mikeoverbay/drum-amp-jukebox/cad/decals/arduino_uno_r3_top_decal.png

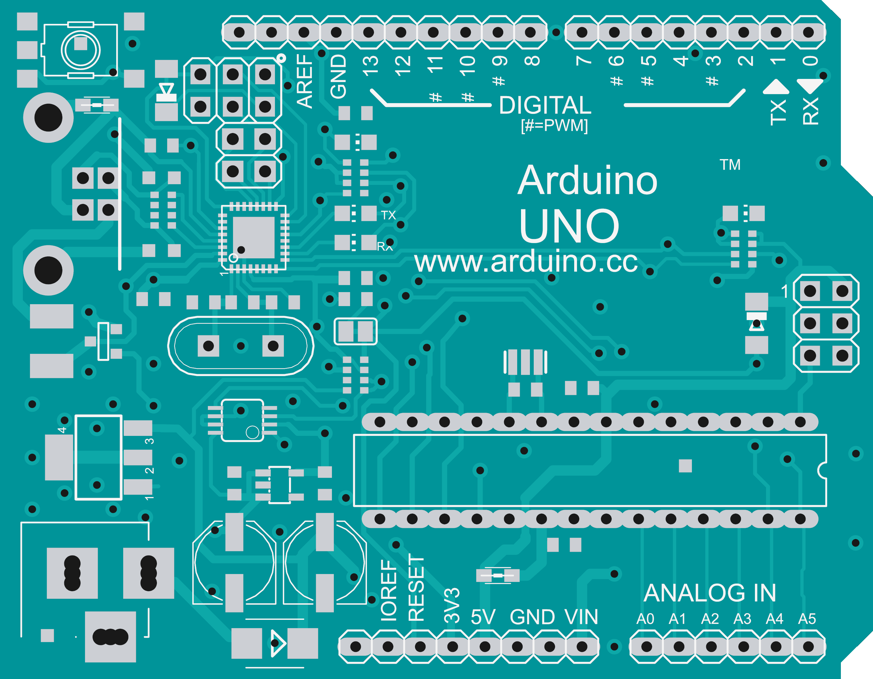
cad/decals/arduino_uno_r3_top_decal.png
