mikeoverbay/drum-amp-jukebox/cad/previews/console_exploded.png

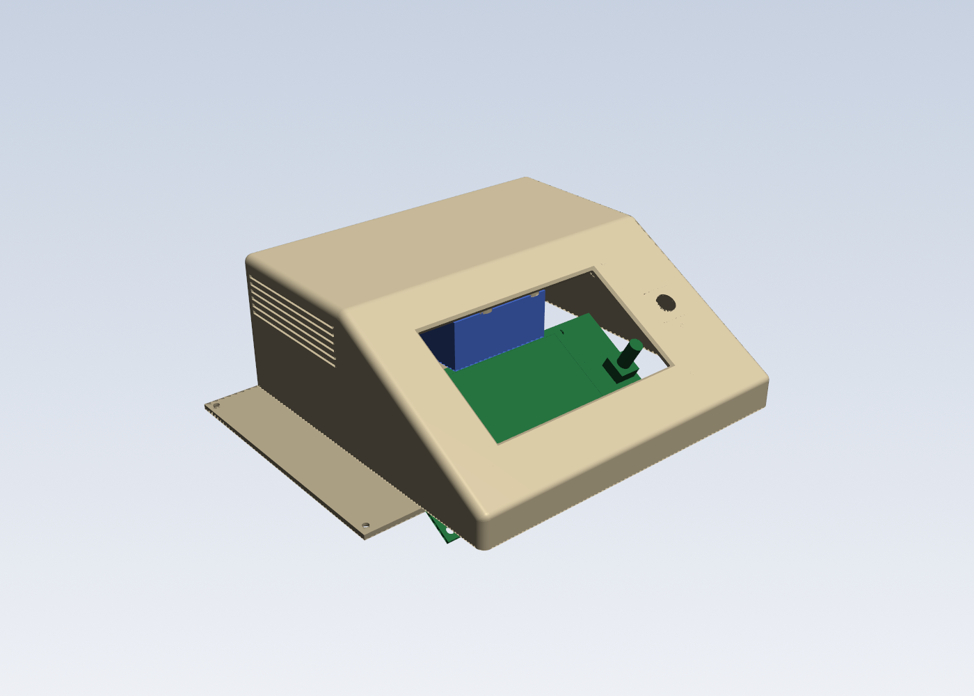
cad/previews/console_exploded.png
