mikeoverbay/drum-amp-jukebox/cad/previews/console_sections.png

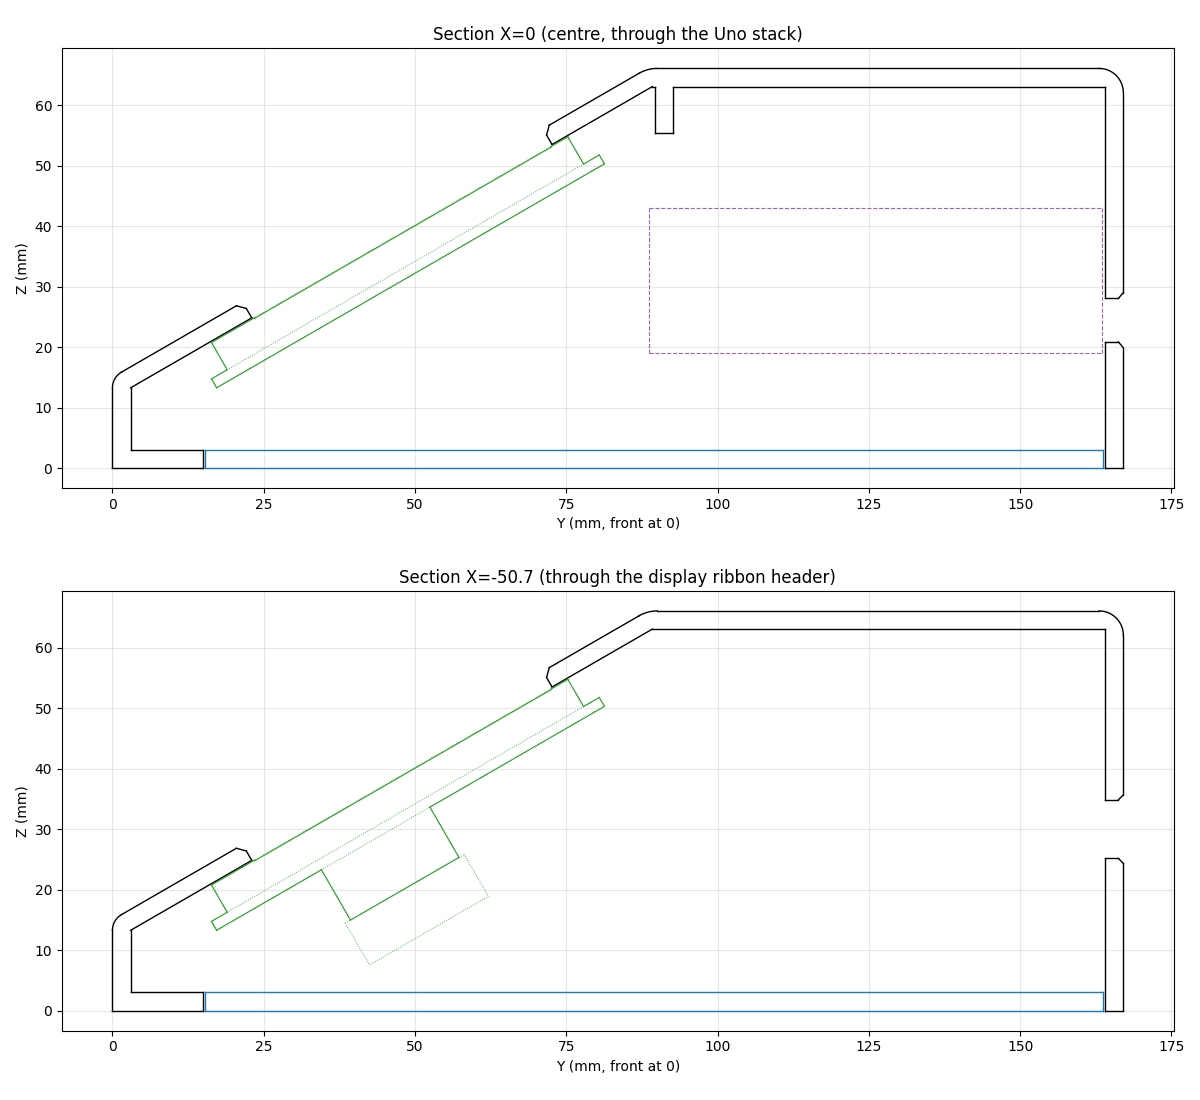
cad/previews/console_sections.png
