mikeoverbay/drum-amp-jukebox/cad/previews/uno_art_top.png

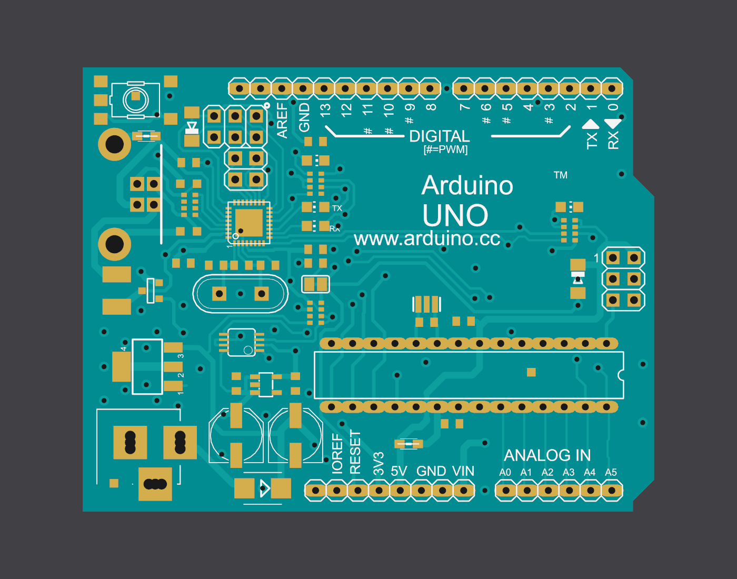
cad/previews/uno_art_top.png
