mikeoverbay/drum-amp-jukebox/cad/previews/uno_coloured.png

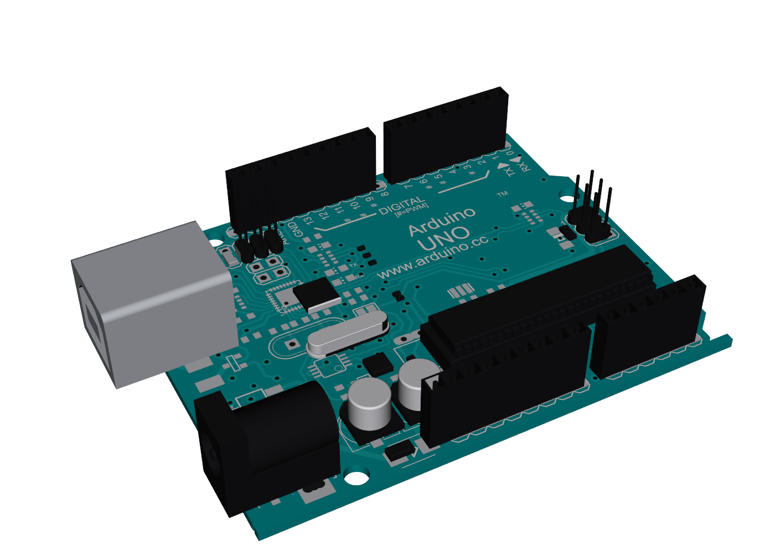
cad/previews/uno_coloured.png
