mikeoverbay/drum-amp-jukebox/cad/previews/vent_closeup.png

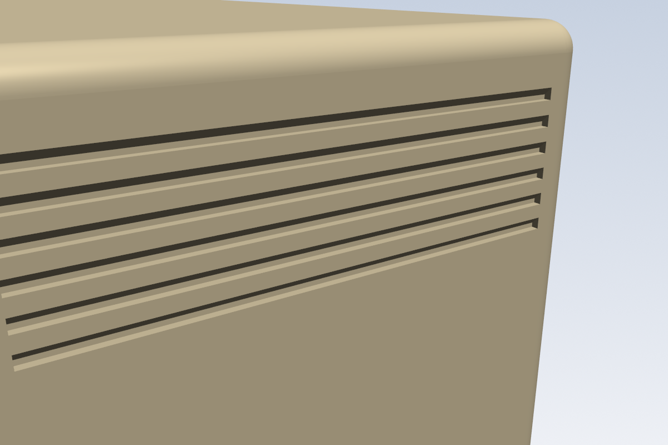
cad/previews/vent_closeup.png
