mikeoverbay/drum-amp-jukebox/cad/previews/vent_section.png

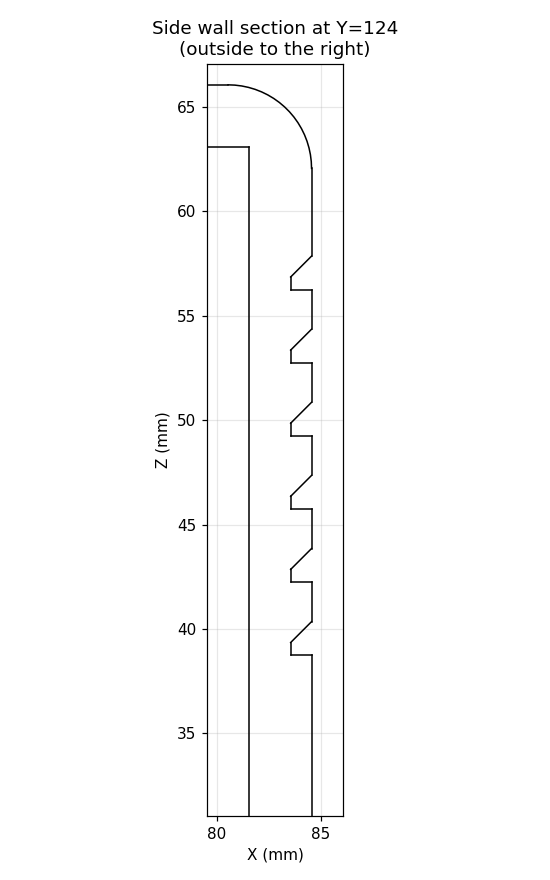
cad/previews/vent_section.png
