mikeoverbay/drum-amp-jukebox/firmware/drum_player/DWIN_SET/0_start.jpg

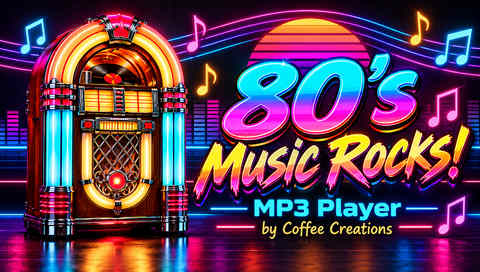
firmware/drum_player/DWIN_SET/0_start.jpg
