mikeoverbay/drum-amp-jukebox/cad/drum_case_assembly.step

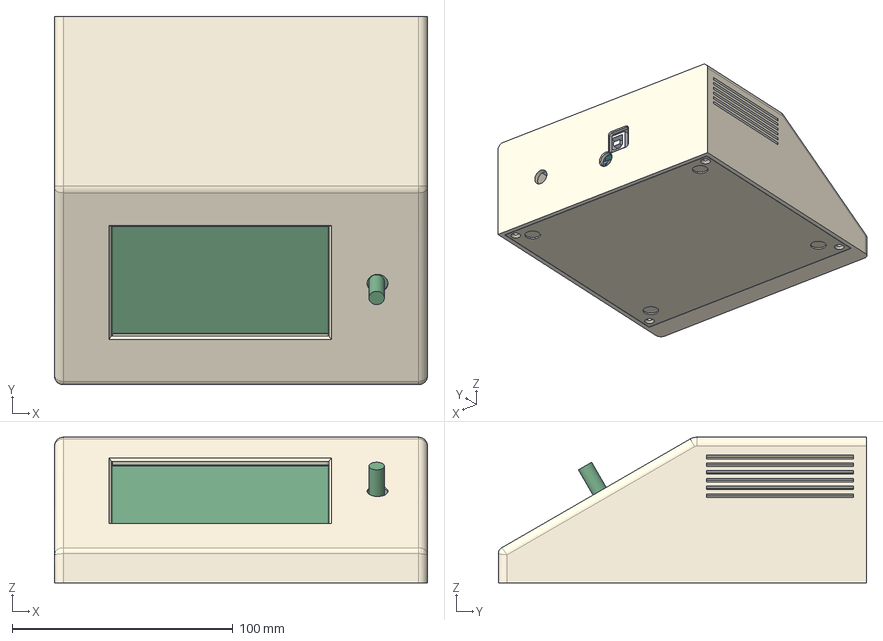
[picture p12: CAD file, 2026-10-24]
cad/drum_case_assembly.step
169.1 x 167.1 x 66.0 mm
hood
bottom_cover
display_DisplayV2
uno
pcb
jack_3_5mm
speaker_terminal_L
speaker_terminal_R
vs1053
microsd
74hc4050
ts2012_amp
regulator
crystal
reset_button
cap_c1
cap_c2
header_plastic_0
header_plastic_1
header_plastic_2
header_plastic_3
header_pins
