mikeoverbay/drum-amp-jukebox/cad/reference/adafruit_music_maker_amp.step

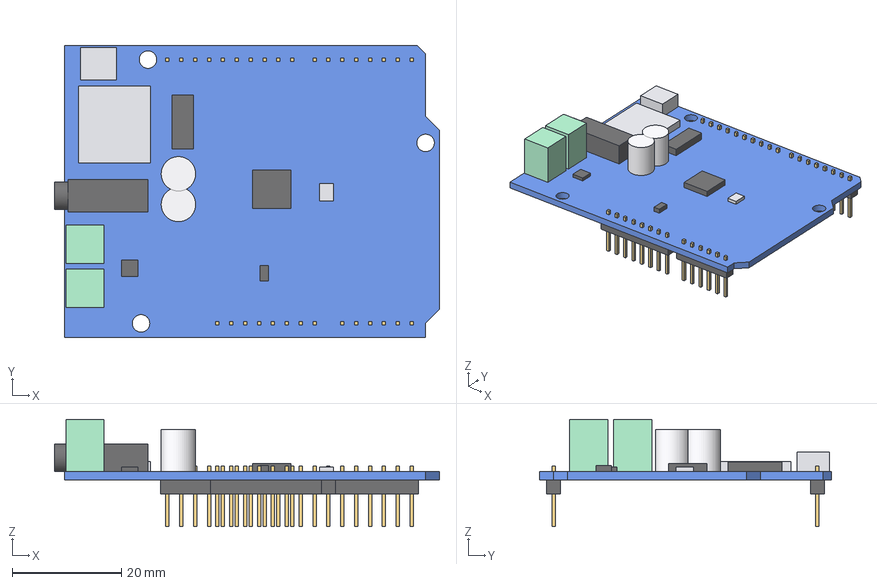
[picture p13: CAD file, 2026-10-23]
cad/reference/adafruit_music_maker_amp.step
70.4 x 53.3 x 19.6 mm
pcb
jack_3_5mm
speaker_terminal_L
speaker_terminal_R
vs1053
microsd
74hc4050
ts2012_amp
regulator
crystal
reset_button
cap_c1
cap_c2
header_plastic_0
header_plastic_1
header_plastic_2
header_plastic_3
header_pins
