mikeoverbay/drum-amp-jukebox/cad/drum_case_hood.step

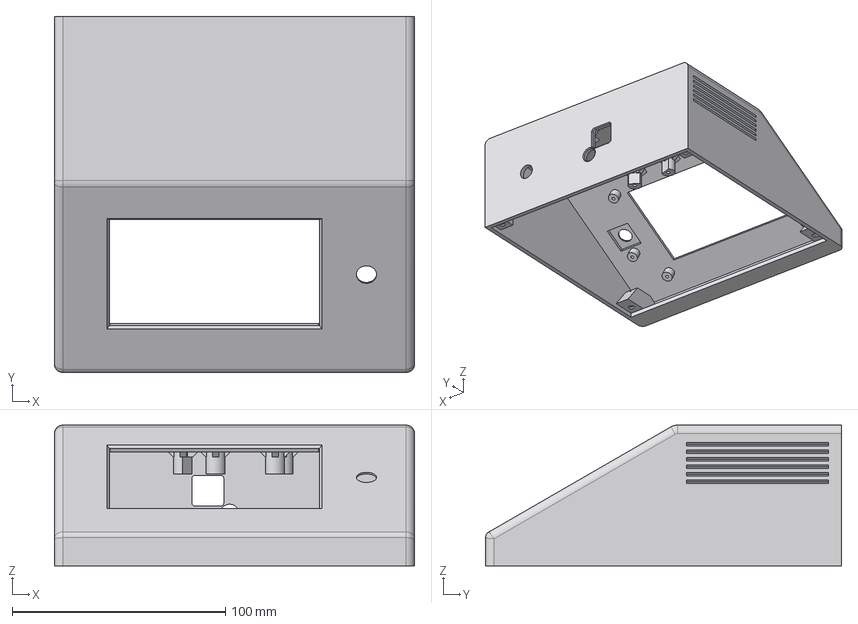
[picture p14: CAD file, 2026-10-24]
cad/drum_case_hood.step
169.1 x 167.1 x 66.0 mm
