mikeoverbay/drum-amp-jukebox/cad/reference/arduino_uno_r3_coloured.step

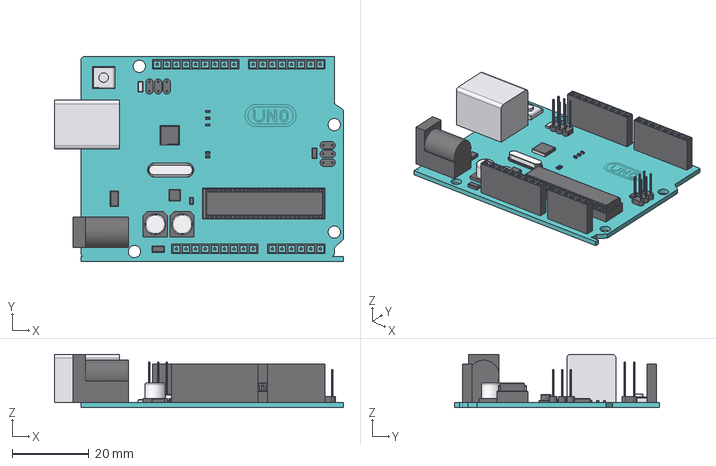
[picture p15: CAD file, 2026-10-23]
cad/reference/arduino_uno_r3_coloured.step
75.3 x 53.3 x 13.9 mm
