mikeoverbay/drum-amp-jukebox/cad/drum_case_bottom_cover.step

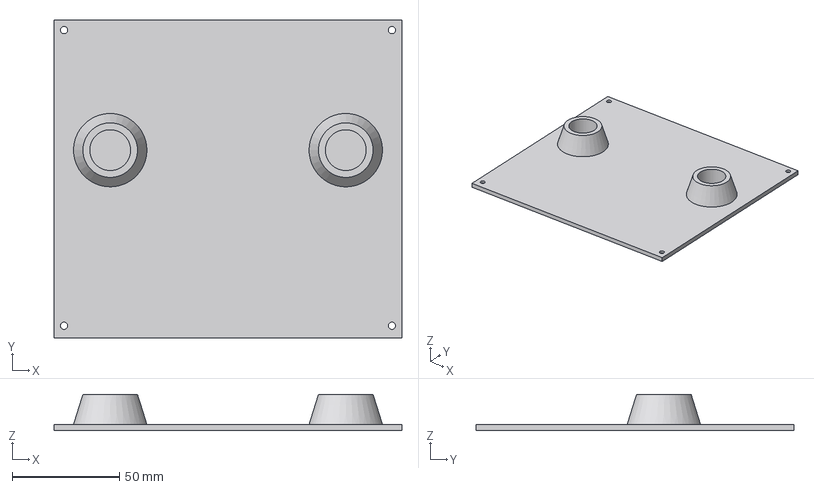
[picture p16: CAD file, 2026-10-24]
cad/drum_case_bottom_cover.step
162.5 x 148.5 x 17.0 mm
