mikeoverbay/drum-amp-jukebox/cad/reference/arduino_uno_r3.step

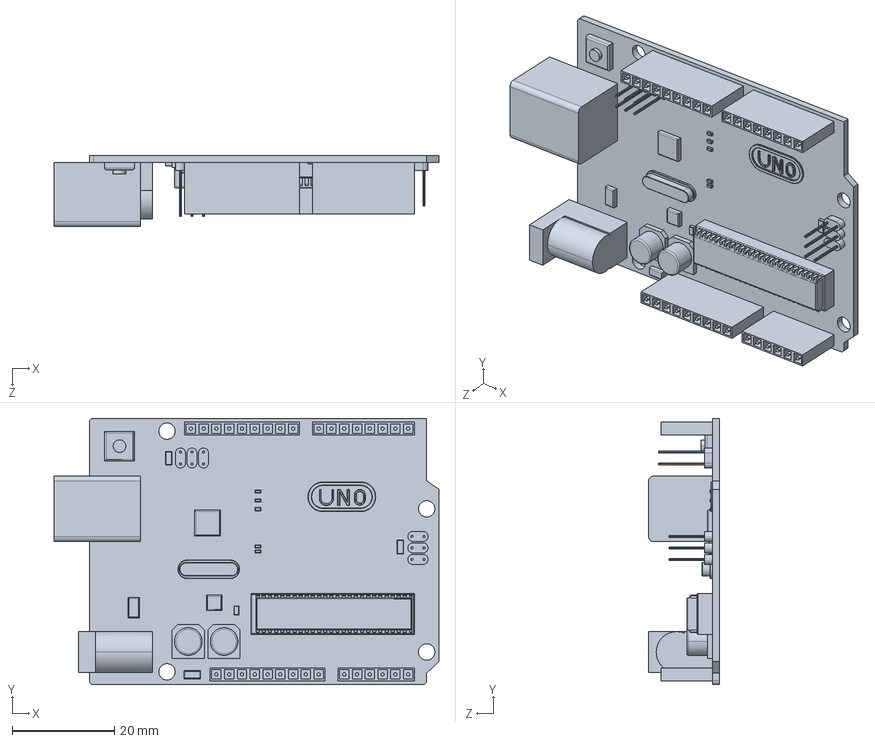
[picture p17: CAD file, 2026-10-21]
cad/reference/arduino_uno_r3.step
75.3 x 52.1 x 13.9 mm
