mikeoverbay/drum-amp-jukebox/cad/reference/DisplayV2.step

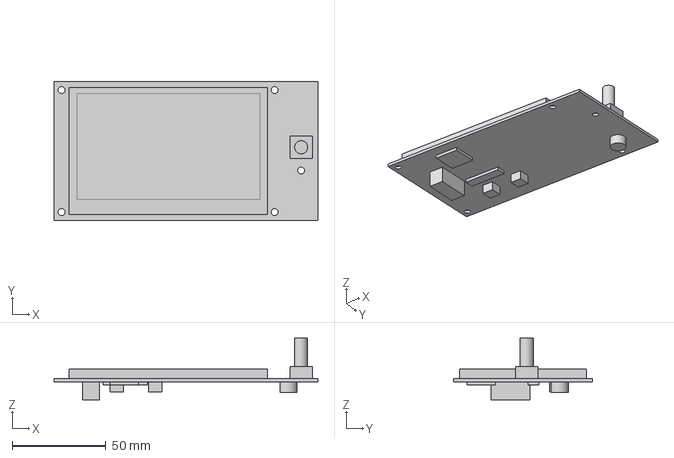
[picture p18: CAD file, 2026-10-21]
cad/reference/DisplayV2.step
141.0 x 74.0 x 32.9 mm
