mikeoverbay/drum-amp-jukebox/(list of files, cad)

Other CAD files:
cad/stl/drum_case_bottom_cover.stl
cad/stl/drum_case_hood.stl
