mikeoverbay/drum-amp-jukebox/cad/decals/music_maker_rev_e_top_decal.png

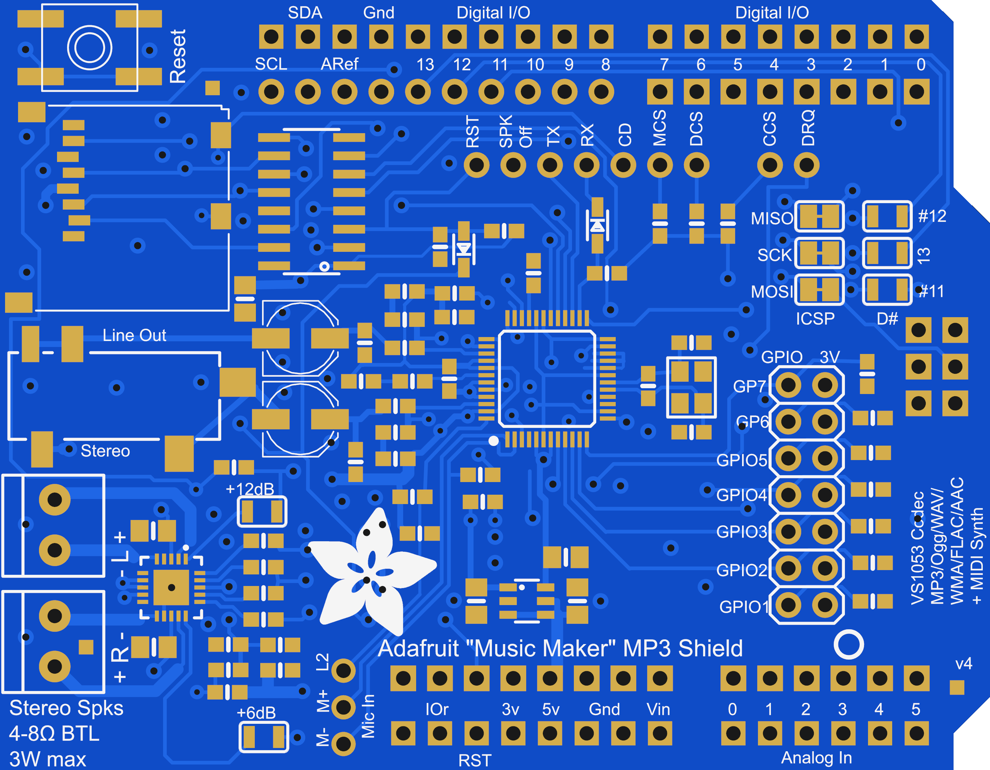
cad/decals/music_maker_rev_e_top_decal.png
