mikeoverbay/drum-amp-jukebox/cad/previews/assembly_back_opening.png

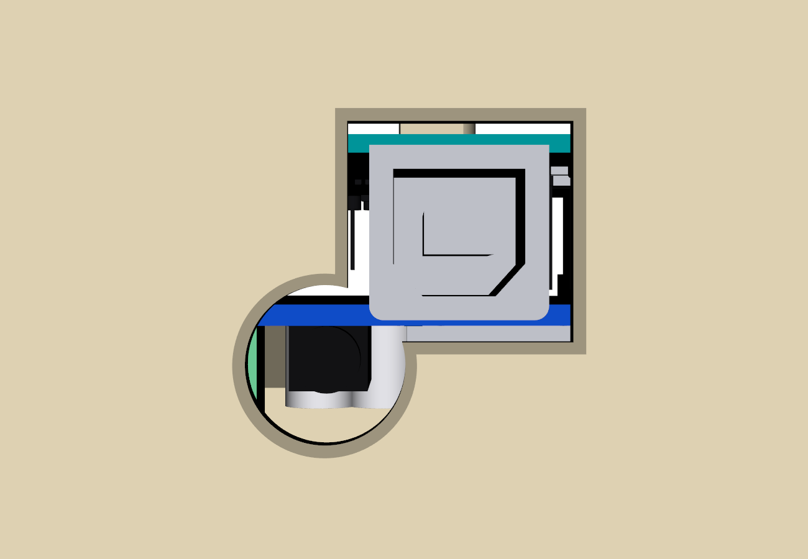
cad/previews/assembly_back_opening.png
