mikeoverbay/drum-amp-jukebox/cad/previews/assembly_inside.png

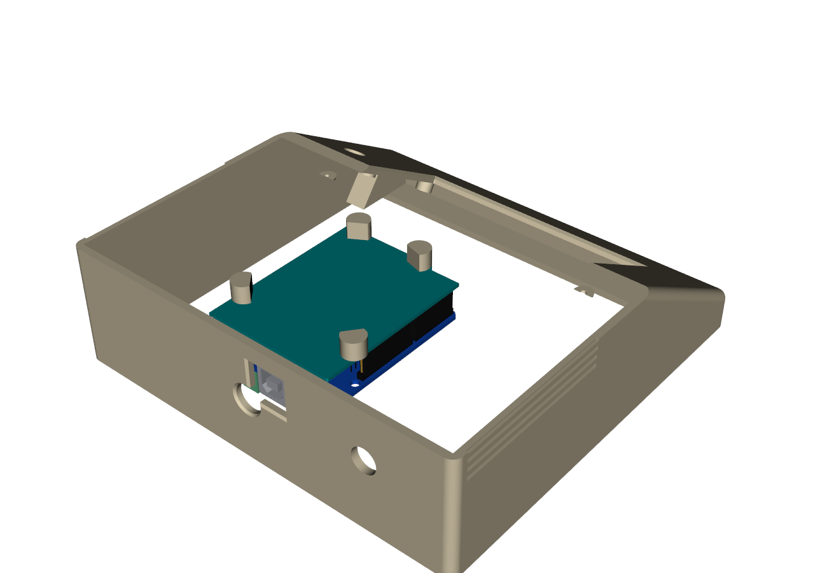
cad/previews/assembly_inside.png
