mikeoverbay/drum-amp-jukebox/cad/previews/music_maker_amp.png

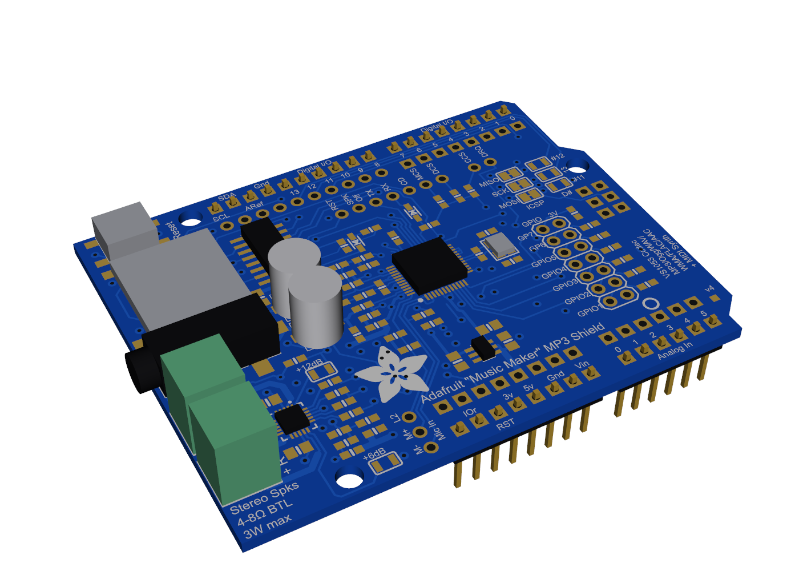
cad/previews/music_maker_amp.png
