mikeoverbay/drum-amp-jukebox/cad/previews/music_maker_art_top.png

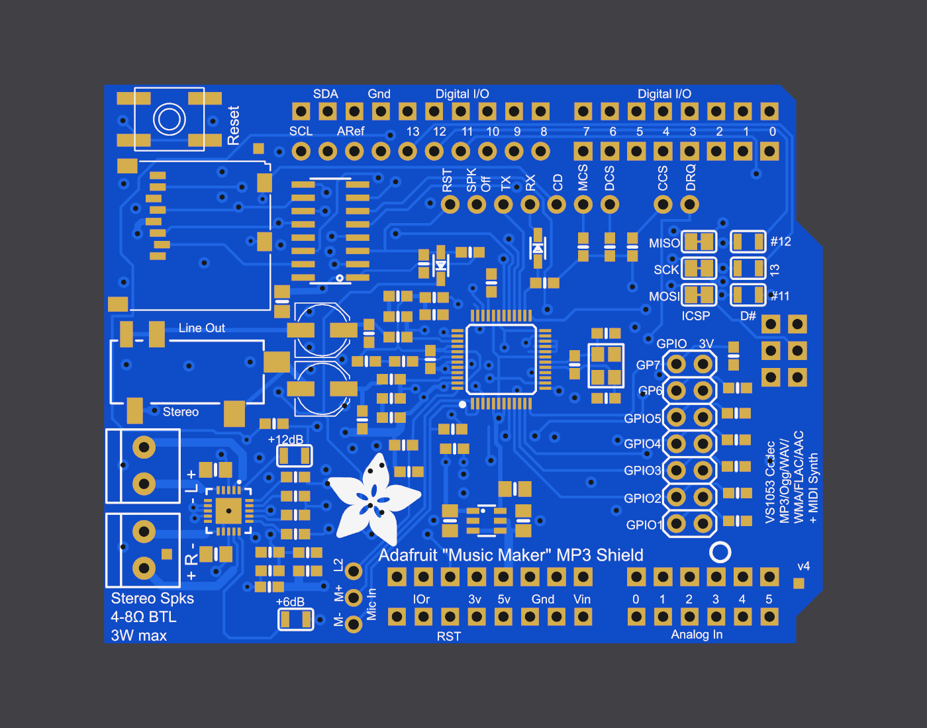
cad/previews/music_maker_art_top.png
