mikeoverbay/drum-amp-jukebox/cad/previews/uno_music_maker_stack.png

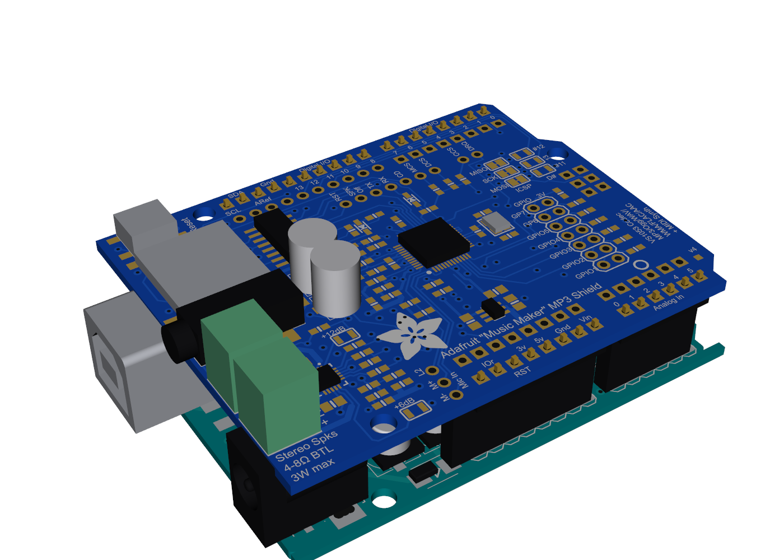
cad/previews/uno_music_maker_stack.png
