mikeoverbay/drum-amp-jukebox/(commit log)

2026-10-21 First commit: drum-amp-jukebox
    Uno + HW-261 VS1053 MP3 jukebox feeding a Donner DDA-80 drum amp, with
    an Ender-3 V2 DWIN screen and knob.
    - firmware/hw261_mp3_player: the sketch, the screen flash set, button art
    - cad: T-shaped printed case (CadQuery source, STEP files, shield and
    reference models)
    - sd-card: song index tool, title list, VS1053 patches
    - docs: parts list and wiring
    [DisplayV2.step, T5UIC1.CFG, arduino_uno_r3.step, drum_case_assembly.step, drum_case_hood.step, drum_case_tray.step, uno_vs1053_stack.step, vs1053_hw261_shield.step]
2026-10-21 Wiring notes from the firmware session
    Knob common to GND, keep D2 and D6-D9 free, which jack is the audio
    out, and the Tone popup.
2026-10-21 Case: back wall on the hood, bottom cover, bevelled screw blocks
    - Back wall moved from the tray to the hood so the hood prints standing
    on its flat back; the tray is now just a floor plate, renamed the
    bottom cover (drum_case_bottom_cover.step).
    - Back pillars replaced by floor-level corner blocks, screws 8 mm in
    from the outside of the walls.
    - Back wall 10 mm further back (REAR_CLEAR 22): 169.1 x 173.9 x 66.
    - Side-wall screw blocks are 45 degree wedges that print without
    support; every pilot has a 0.8 mm lead-in chamfer.
    [drum_case_assembly.step, drum_case_bottom_cover.step, drum_case_hood.step, drum_case_tray.step]
2026-10-21 Rename firmware to drum_player; clean out old case code
    - firmware/hw261_mp3_player -> firmware/drum_player (drum_player.ino),
    matching the renamed Documents\Arduino\drum_player sketch; old folder
    names updated in the docs and MakeSongIndex.ps1.
    - drum_case.py: tray -> bottom cover throughout (make_bottom_cover),
    pillars -> back screws; removed the unused deck text, lid seam, vents,
    power-jack hole option and back-on-tray/lip option. The exported
    hood and bottom cover are unchanged (same volumes).
    - README: dropped notes about the removed options.
    [T5UIC1.CFG, drum_case_assembly.step, drum_case_bottom_cover.step, drum_case_hood.step]
2026-10-21 Add shaded PNG views of the case and the script that renders them
    cad/render_views.py tessellates the exported hood and bottom cover and
    draws front, back, underneath and assembly views with matplotlib.
2026-10-22 Switch to the Music Maker and the console case
    - firmware/drum_player: now runs on the Adafruit Music Maker
    (player(-1, 7, 6, 3, 4), SD CS 4); the red HW-261 shield is dropped.
    docs/wiring.md and README updated to match (from the firmware session).
    - cad/: the T-shaped drum case and the HW-261 shield model are replaced
    by the sloped console case (the coffee player's design):
    - stl/hood.stl, stl/bottom_cover.stl and case_assembly.step are
    mikeoverbay's Shapr3D edit, with Uno standoff corners trimmed to
    clear the sockets' solder pins. These are the files to print.
    - console_case.py is the parametric base design; it now finds its
    reference models in cad/reference and write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
    [bottom_cover.stl, case_assembly.step, drum_case_assembly.step, drum_case_bottom_cover.step, drum_case_hood.step, hood.stl, uno_vs1053_stack.step, vs1053_hw261_shield.step]
2026-10-22 Use mikeoverbay's hood, add the Music Maker model, firmware fixes
    Case (cad/):
    - Hood is mikeoverbay's Shapr3D edit: one opening for USB-B and the
    headphone jack, one 1/4" jack hole on the USB side.
    - drum_case.py (base design): console case renamed, Uno hole at
    Arduino's (13.97, 2.54), 0.6 mm elephant's-foot chamfer on the back,
    USB hole at Arduino's position, headphone hole on Adafruit's jack axis,
    one 1/4" jack. Writes only to generated/ so it can't overwrite the
    hand-edited hood.
    - music_maker_shield.py: Adafruit Music Maker amp (1788) model from
    Adafruit's board file, placed in the assembly with a jack/clash check.
    Firmware: knob direction (menu reversed, values counted the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
    [adafruit_music_maker_amp.step, bottom_cover.stl, case_assembly.step, drum_case_bottom_cover.step, drum_case_bottom_cover.stl, drum_case_hood.step, drum_case_hood.stl, hood.stl]
2026-10-23 Add a coloured Uno model to match the Music Maker
    cad/color_uno.py colours the Uno STEP face by face (teal board, steel
    USB-B, black headers/jack/chips, silver caps), from the copy with the
    corrected mounting hole and board edge. Output:
    cad/reference/arduino_uno_r3_coloured.step, plus preview renders of the
    Uno alone and with the Music Maker stacked on it.
    [arduino_uno_r3_coloured.step]
2026-10-23 Board artwork from the open-source board files; Rev E Music Maker
    - cad/board_art.py draws a board's top side straight from its Eagle .brd:
    copper traces, pads, drill holes and silkscreen (logos, labels, text),
    as thin coloured sheets. Text turns and stacks the way Eagle does.
    - cad/reference/boards: Adafruit's Music Maker Rev E (CC BY-SA 3.0) and
    Arduino's UNO Rev3e (CC BY-SA 4.0) board files, with their licences.
    - music_maker_shield.py: Rev E board (PJ-328 jack, green terminals),
    artwork with gold pads.
    - color_uno.py: Uno as an assembly with per-face colours, the model's
    raised logo shaved off, artwork with tinned pads.
    - drum_case.py: back wall matches mikeoverbay's hood (one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
    [Adafruit-Music-Maker-MP3-Shield-RevE.brd, UNO-TH_Rev3e.brd, adafruit_music_maker_amp.step, arduino_uno_r3_coloured.step]
2026-10-23 Add the full assembly built on mikeoverbay's hood
    cad/make_assembly.py puts the hand-edited hood, the bottom cover, the
    screen and the coloured Uno and Rev E Music Maker (with their board
    artwork) together, placed as drum_case.py places them. Output:
    cad/drum_case_assembly.step. No clashes between the boards and the hood.
    [drum_case_assembly.step]
2026-10-23 Plain STEPs for Shapr3D, artwork as decals
    Shapr3D crashes on the board artwork sheets, so the main STEP files
    (Music Maker, Uno, drum_case_assembly) are now without artwork and open
    there. The artwork versions are kept as *_with_artwork.step for other
    viewers. make_decals.py renders each board's top-side artwork as a PNG
    (40 px/mm, transparent outside the outline) to put on the board as a
    Shapr3D decal, sized 68.58 x 53.34 mm.
    [adafruit_music_maker_amp.step, adafruit_music_maker_amp_with_artwork.step, arduino_uno_r3_coloured.step, arduino_uno_r3_coloured_with_artwork.step, drum_case_assembly.step, drum_case_assembly_with_artwork.step]
2026-10-23 Drop the STEP files with built-in board artwork
    mikeoverbay prefers the plain models, and Shapr3D crashes on the artwork
    versions. Removed drum_case_assembly_with_artwork.step and the Music
    Maker and Uno *_with_artwork.step files; the scripts now only write the
    plain models. Board artwork stays available as the decal PNGs.
    [adafruit_music_maker_amp_with_artwork.step, arduino_uno_r3_coloured_with_artwork.step, drum_case_assembly_with_artwork.step]
2026-10-24 mikeoverbay's updated hood and bottom cover
    Hood and bottom cover (STEP and STL) copied unchanged from his Shapr3D
    edits: hole positions set from his own boards, and penny pockets in the
    cover for weight. Assembly rebuilt around them; README note updated.
    [drum_case_assembly.step, drum_case_bottom_cover.step, drum_case_bottom_cover.stl, drum_case_hood.step, drum_case_hood.stl]
